Peterskhan/Rhea/Rhea - ESP32_WROOM32D.sch

## KiCad design Rhea - ESP32_WROOM32D.sch (2020-02-20)

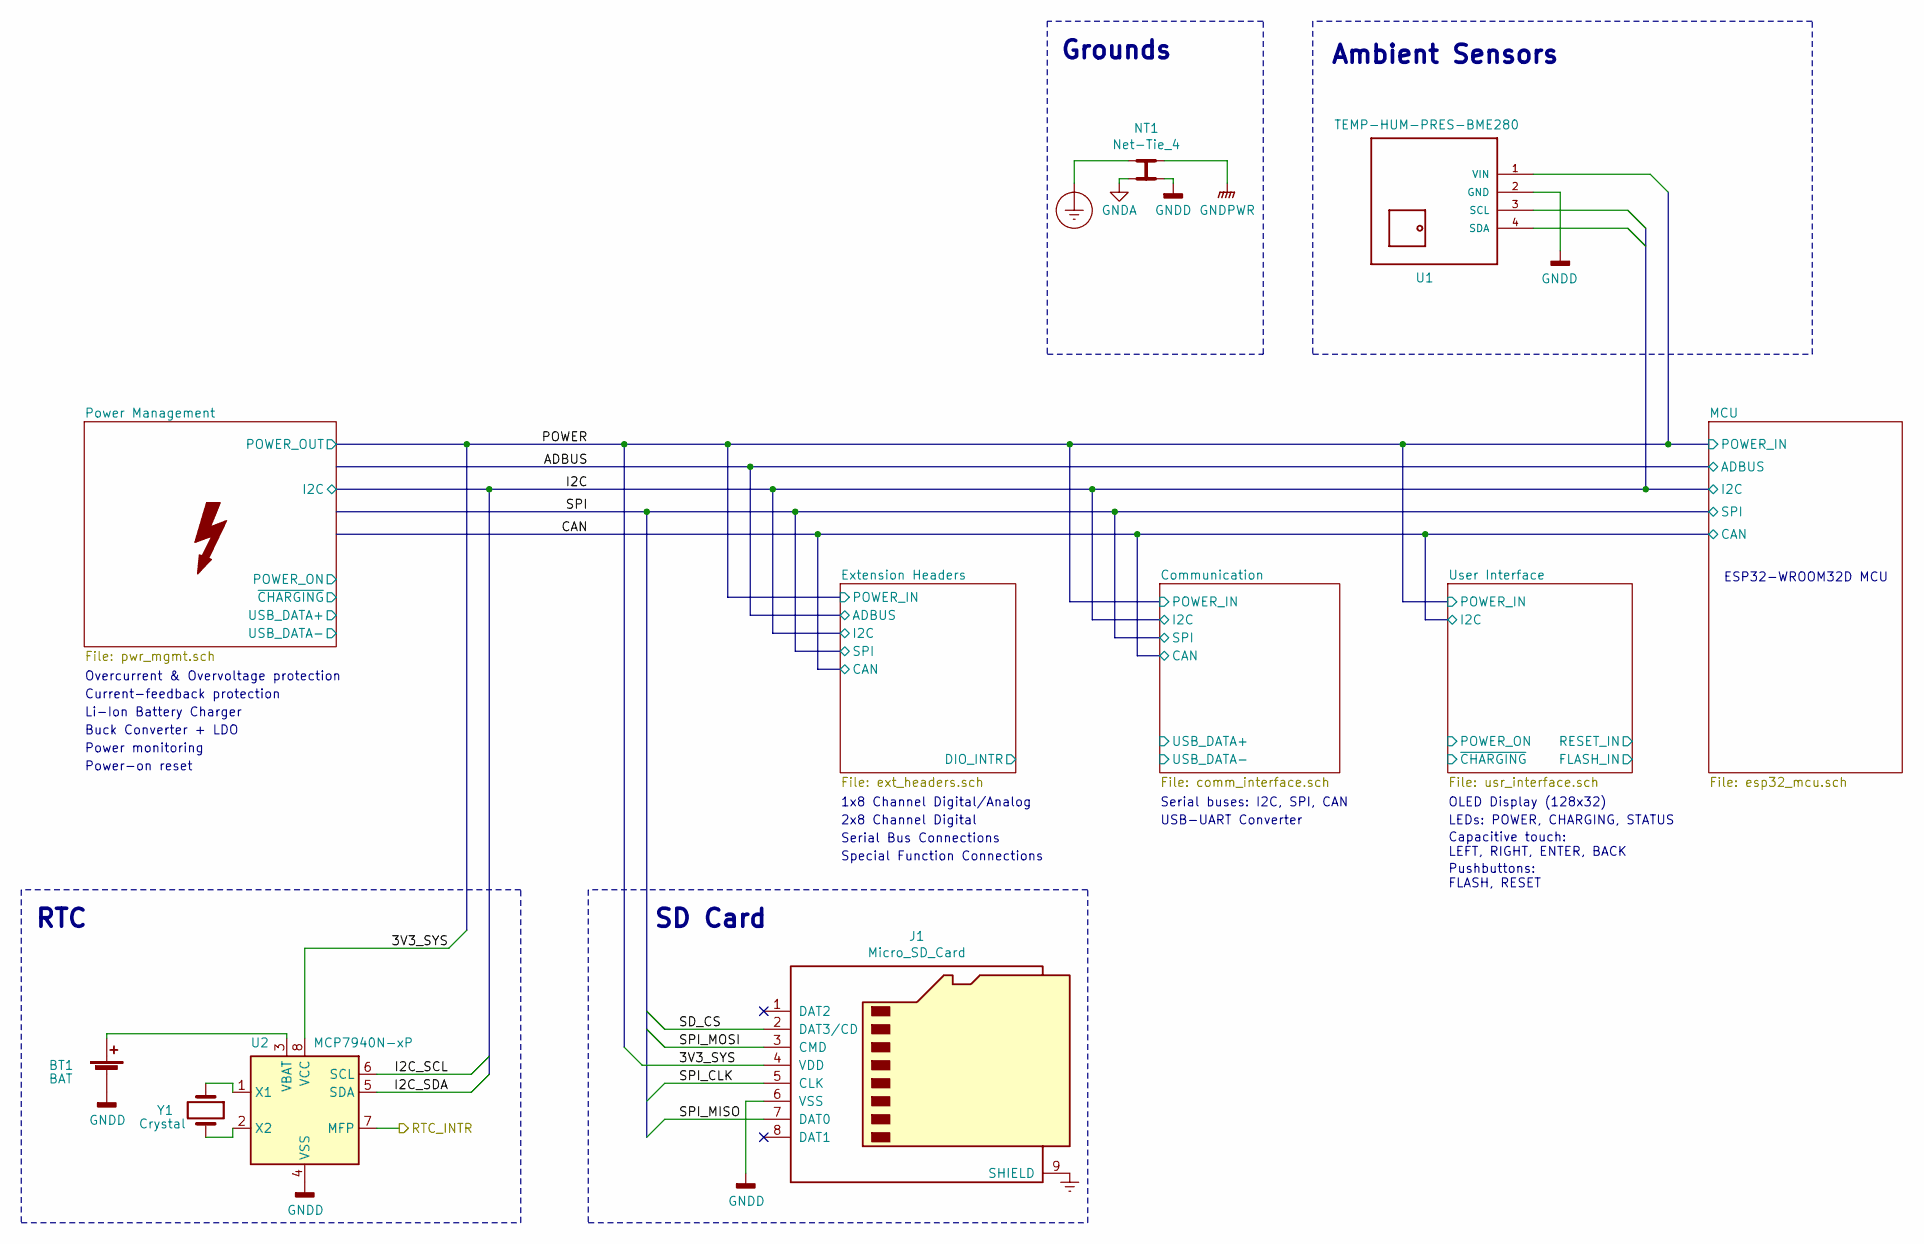
[picture p9: schematic Rhea - ESP32_WROOM32D.sch]

Parts:
BT1: BAT
J1: Micro_SD_Card
NT1: Net-Tie_4
U1: TEMP-HUM-PRES-BME280
U2: MCP7940N-xP
Y1: Crystal

Connections:
3V3_SYS: J1.4 (VDD), U2.8 (VCC)
Earth: J1.9 (SHIELD)
Earth_Protective: NT1.1
GNDA: NT1.3
GNDD: BT1.2 (-), J1.6 (VSS), NT1.4, U1.2 (GND), U2.4 (VSS)
GNDPWR: NT1.2
I2C_SCL: U2.6 (SCL)
I2C_SDA: U2.5 (SDA)
unnamed: BT1.1 (+), U2.3 (VBAT)
unnamed: U2.1 (X1), Y1.1
unnamed: U2.2 (X2), Y1.2
RTC_INTR: U2.7 (MFP)
SD_CS: J1.2 (DAT3/CD)
SPI_CLK: J1.5 (CLK)
SPI_MISO: J1.7 (DAT0)
SPI_MOSI: J1.3 (CMD)

Notes on the sheet:
Overcurrent & Overvoltage protection
Buck Converter + LDO
Current-feedback protection
Power monitoring
Power-on reset
Li-Ion Battery Charger
ESP32-WROOM32D MCU
Serial buses: I2C, SPI, CAN
1x8 Channel Digital/Analog
Pushbuttons: FLASH, RESET
Capacitive touch: LEFT, RIGHT, ENTER, BACK
LEDs: POWER, CHARGING, STATUS
OLED Display (128x32)
RTC
SD Card
Ambient Sensors
2x8 Channel Digital
Serial Bus Connections
Special Function Connections
USB-UART Converter
Grounds
