Peterskhan/Rhea/esp32_mcu.sch

## KiCad design esp32_mcu.sch (2020-02-20)

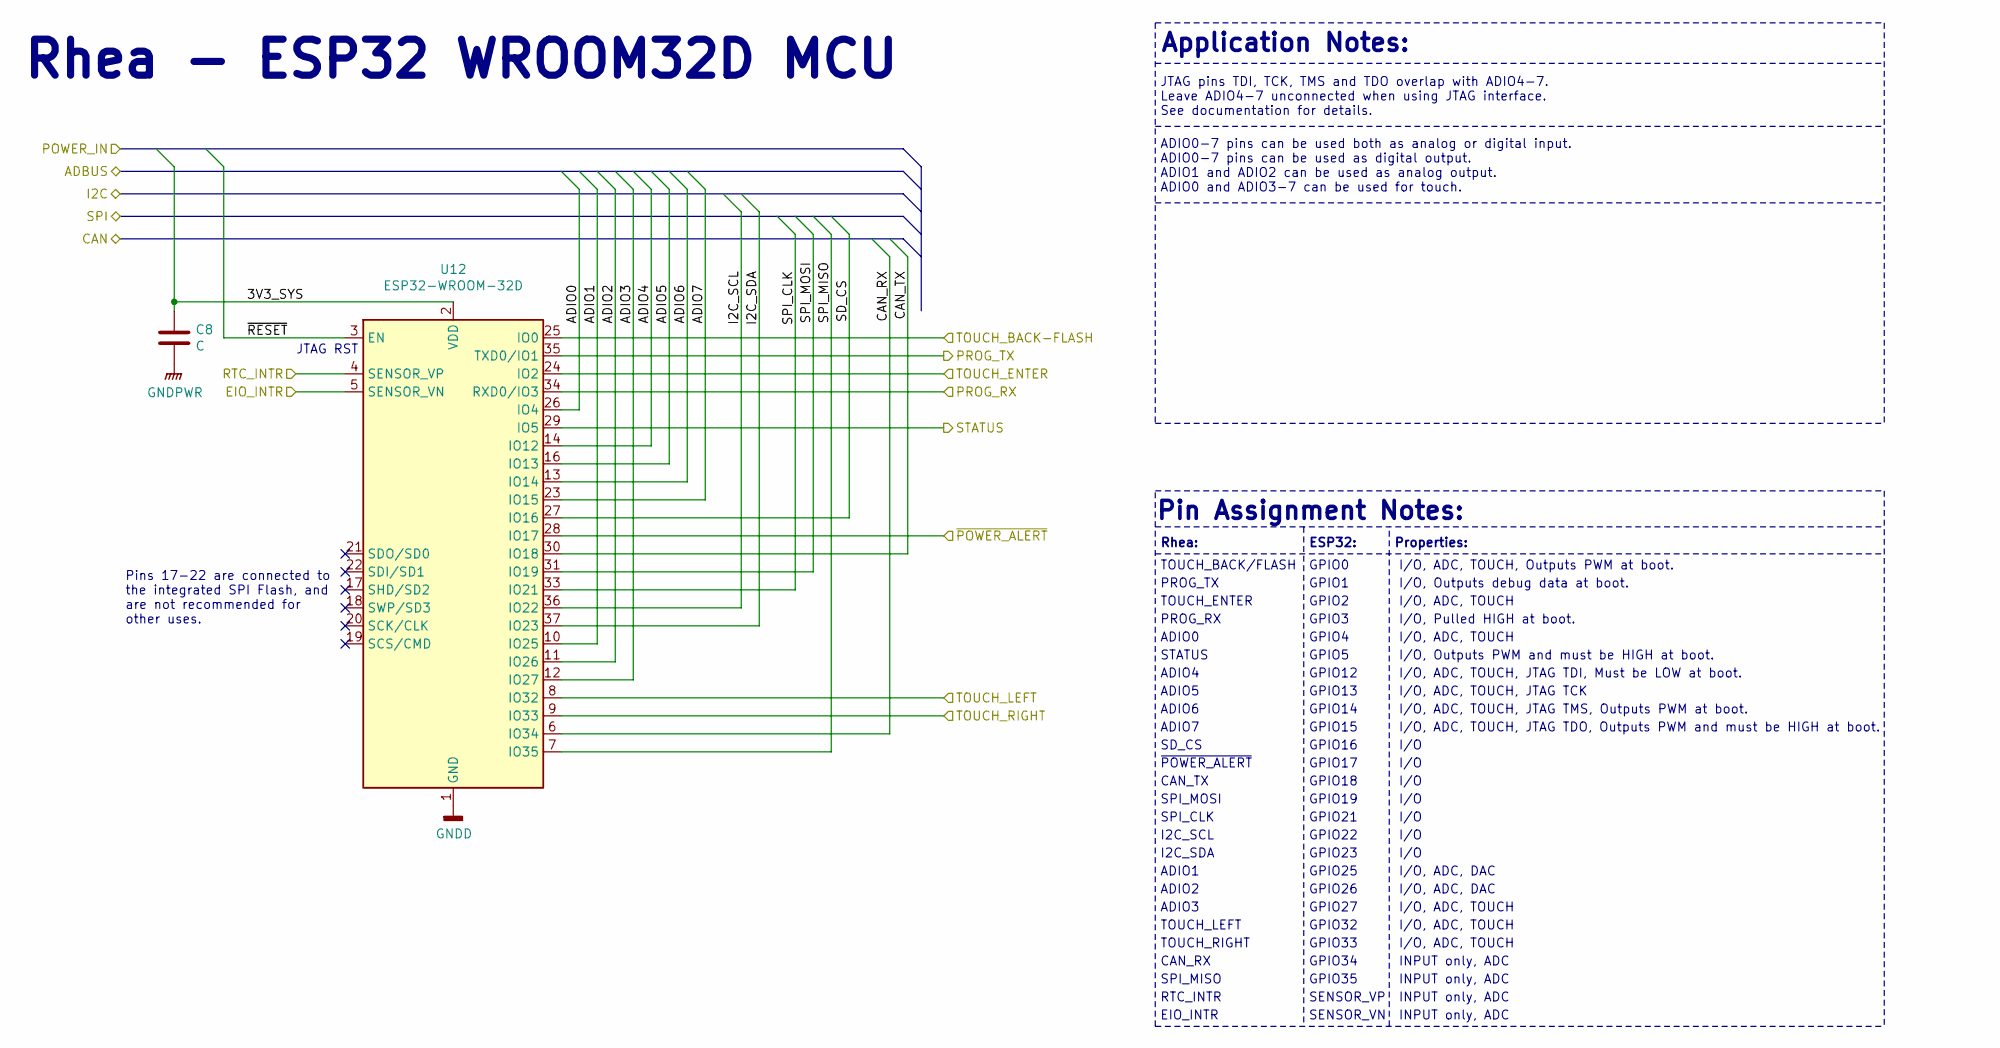
[picture p10: schematic esp32_mcu.sch]

Parts:
C8: C
U12: ESP32-WROOM-32D; ESP32-WROOM-32

Connections:
3V3_SYS: C8.1, U12.2 (VDD)
ADIO0: U12.26 (IO4)
ADIO1: U12.10 (IO25)
ADIO2: U12.11 (IO26)
ADIO3: U12.12 (IO27)
ADIO4: U12.14 (IO12)
ADIO5: U12.16 (IO13)
ADIO6: U12.13 (IO14)
ADIO7: U12.23 (IO15)
CAN_RX: U12.6 (IO34)
CAN_TX: U12.30 (IO18)
EIO_INTR: U12.5 (SENSOR_VN)
GNDD: U12.1 (GND), U12.15 (GND), U12.38 (GND)
GNDPWR: C8.2
I2C_SCL: U12.36 (IO22)
I2C_SDA: U12.37 (IO23)
PROG_RX: U12.34 (RXD0/IO3)
PROG_TX: U12.35 (TXD0/IO1)
RTC_INTR: U12.4 (SENSOR_VP)
SD_CS: U12.27 (IO16)
SPI_CLK: U12.33 (IO21)
SPI_MISO: U12.7 (IO35)
SPI_MOSI: U12.31 (IO19)
STATUS: U12.29 (IO5)
TOUCH_BACK-FLASH: U12.25 (IO0)
TOUCH_ENTER: U12.24 (IO2)
TOUCH_LEFT: U12.8 (IO32)
TOUCH_RIGHT: U12.9 (IO33)
~POWER_ALERT: U12.28 (IO17)
~RESET: U12.3 (EN)

Notes on the sheet:
I/O, ADC, TOUCH, Outputs PWM at boot.
INPUT only, ADC
I/O, Outputs debug data at boot.
I/O, ADC, TOUCH
I/O, Pulled HIGH at boot.
I/O, Outputs PWM and must be HIGH at boot.
I/O, ADC, TOUCH, JTAG TDI, Must be LOW at boot.
I/O, ADC, TOUCH, JTAG TCK
I/O, ADC, TOUCH, JTAG TMS, Outputs PWM at boot.
I/O, ADC, TOUCH, JTAG TDO, Outputs PWM and must be HIGH at boot.
I/O
I/O, ADC, DAC
JTAG RST
TOUCH_RIGHT
ADIO2
ADIO1
TOUCH_BACK/FLASH
TOUCH_ENTER
TOUCH_LEFT
ADIO3
ADIO0
ADIO4
ADIO5
ADIO6
ADIO7
I2C_SCL
I2C_SDA
SPI_MISO
SPI_MOSI
SPI_CLK
CAN_RX
CAN_TX
STATUS
JTAG pins TDI, TCK, TMS and TDO overlap with ADIO4-7. Leave ADIO4-7 unconnected when using JTAG interface. See documentation for details.
Application Notes:
ADIO0-7 pins can be used both as analog or digital input. ADIO0-7 pins can be used as digital output. ADIO1 and ADIO2 can be used as analog output. ADIO0 and ADIO3-7 can be used for touch.
Pin Assignment Notes:
SD_CS
PROG_RX
PROG_TX
Pins 17-22 are connected to the integrated SPI Flash, and are not recommended for other uses.
Rhea:
ESP32:
Properties:
GPIO0
GPIO1
GPIO2
GPIO3
GPIO4
GPIO5
GPIO12
GPIO13
GPIO14
GPIO15
GPIO16
GPIO17
GPIO18
GPIO19
GPIO21
GPIO22
GPIO23
GPIO25
GPIO26
GPIO27
GPIO32
GPIO33
GPIO34
GPIO35
SENSOR_VP
SENSOR_VN
RTC_INTR
EIO_INTR
Rhea - ESP32 WROOM32D MCU
~POWER_ALERT
