Peterskhan/Rhea/ext_headers.sch

## KiCad design ext_headers.sch (2020-02-20)

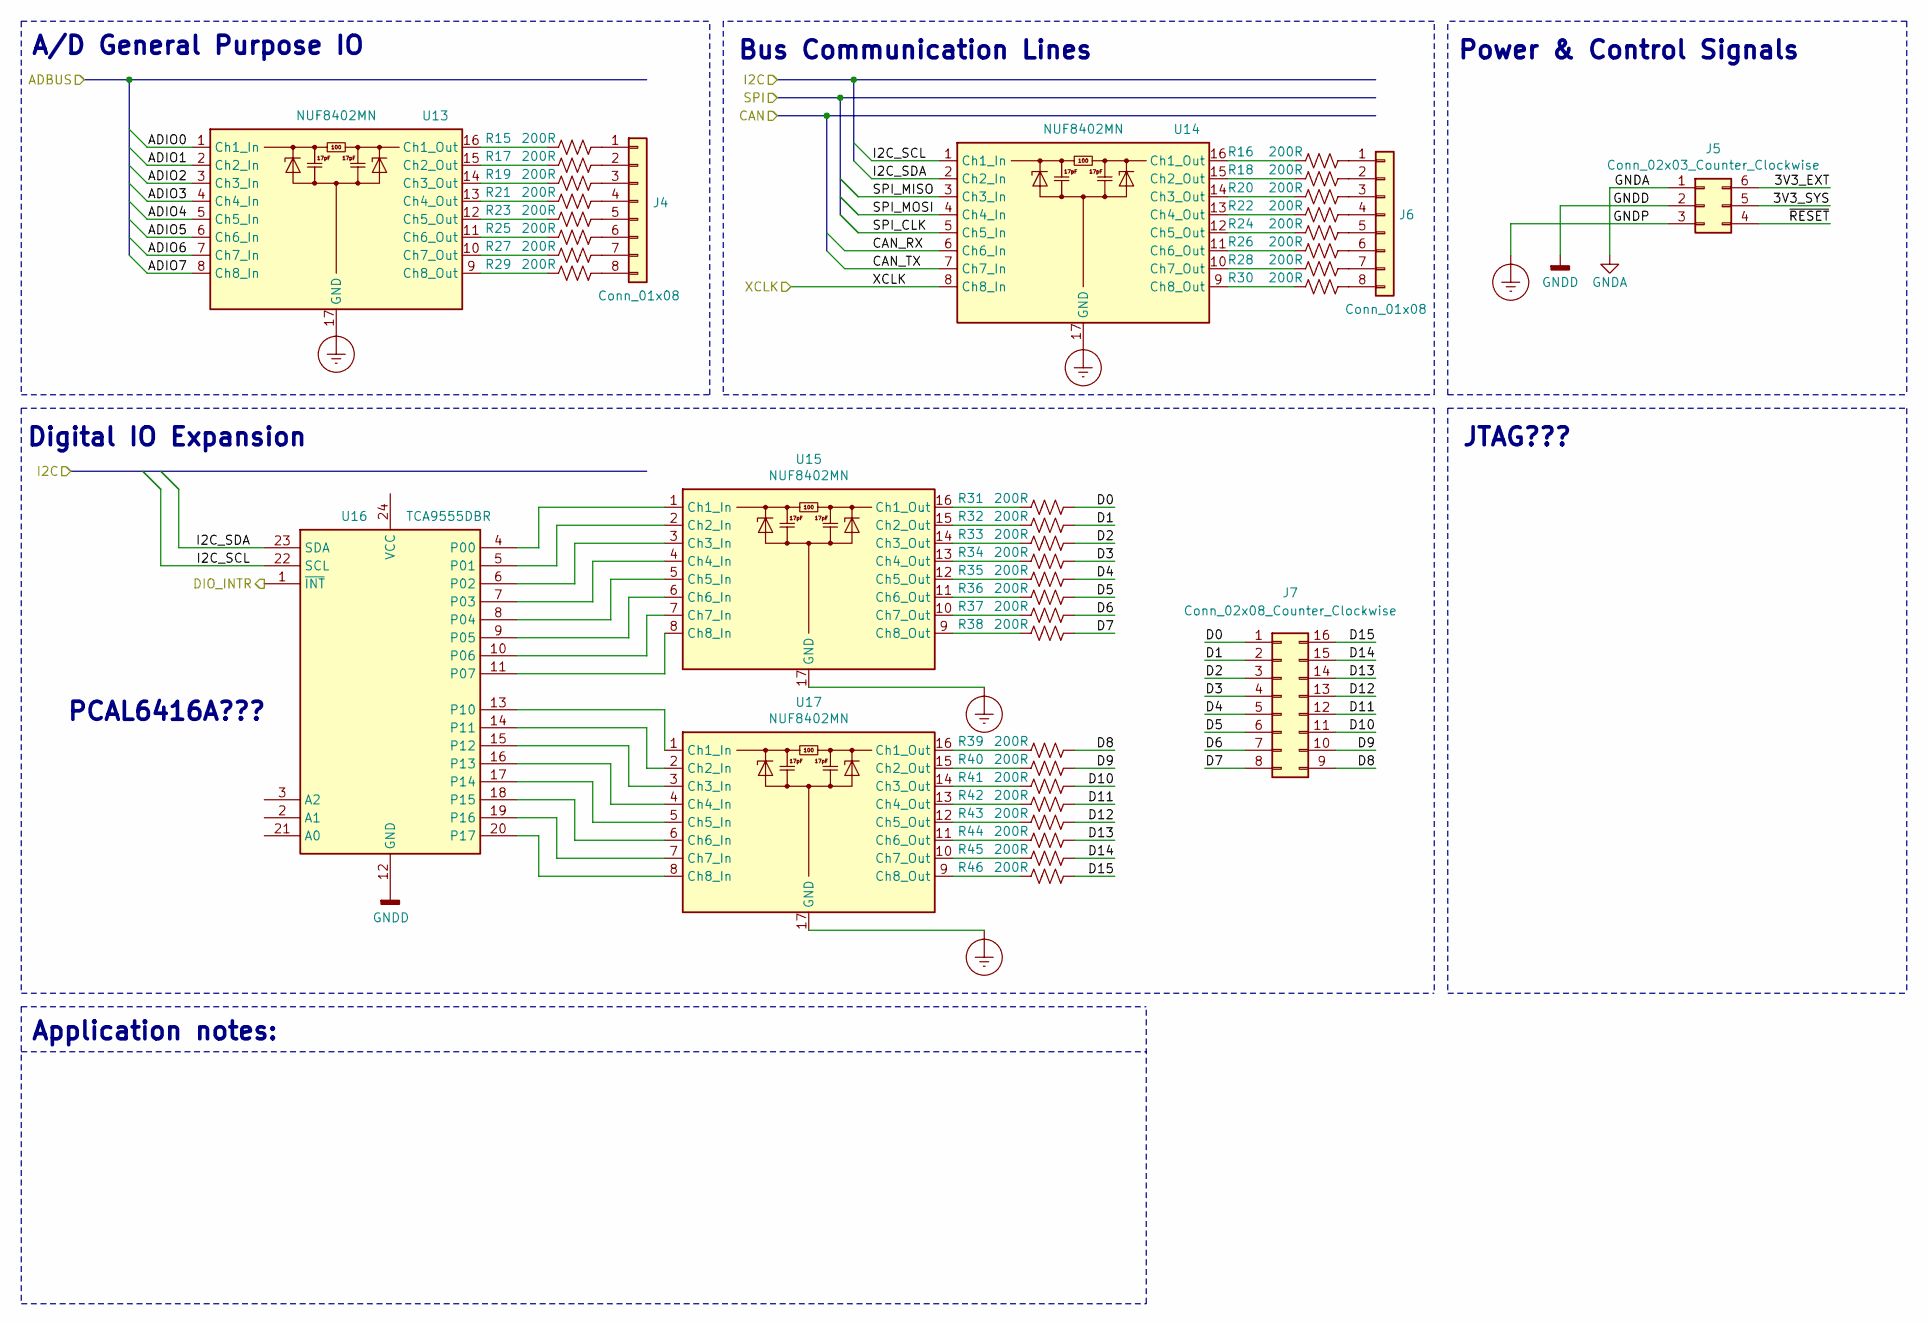
[picture p11: schematic ext_headers.sch]

Parts:
J4, J6: Conn_01x08
J5: Conn_02x03_Counter_Clockwise
J7: Conn_02x08_Counter_Clockwise
R15, R16, R17, R18, R19, R20, R21, R22, R23, R24, R25, R26, R27, R28, R29, R30, R31, R32, R33, R34, R35, R36, R37, R38, R39, R40, R41, R42, R43, R44, R45, R46: 200R
U13, U14, U15, U17: NUF8402MN; DFN-16-1EP_3x5mm_P0.5mm_EP1.66x4.4mm
U16: TCA9555DBR; SSOP-24_5.3x8.2mm_P0.65mm

Connections:
3V3_EXT: J5.6
3V3_SYS: J5.5
ADIO0: U13.1 (Ch1_In)
ADIO1: U13.2 (Ch2_In)
ADIO2: U13.3 (Ch3_In)
ADIO3: U13.4 (Ch4_In)
ADIO4: U13.5 (Ch5_In)
ADIO5: U13.6 (Ch6_In)
ADIO6: U13.7 (Ch7_In)
ADIO7: U13.8 (Ch8_In)
CAN_RX: U14.6 (Ch6_In)
CAN_TX: U14.7 (Ch7_In)
D0: J7.1, R31.1
D1: J7.2, R32.1
D2: J7.3, R33.1
D3: J7.4, R34.1
D4: J7.5, R35.1
D5: J7.6, R36.1
D6: J7.7, R37.1
D7: J7.8, R38.1
D8: J7.9, R39.1
D9: J7.10, R40.1
D10: J7.11, R41.1
D11: J7.12, R42.1
D12: J7.13, R43.1
D13: J7.14, R44.1
D14: J7.15, R45.1
D15: J7.16, R46.1
DIO_INTR: U16.1 (~INT)
Earth_Protective: J5.3, U13.17 (GND), U14.17 (GND), U15.17 (GND), U17.17 (GND)
GNDA: J5.1
GNDD: J5.2, U16.12 (GND)
I2C_SCL: U14.1 (Ch1_In), U16.22 (SCL)
I2C_SDA: U14.2 (Ch2_In), U16.23 (SDA)
unnamed: J4.1, R15.1
unnamed: J4.2, R17.1
unnamed: J4.3, R19.1
unnamed: J4.4, R21.1
unnamed: J4.5, R23.1
unnamed: J4.6, R25.1
unnamed: J4.7, R27.1
unnamed: J4.8, R29.1
unnamed: J6.1, R16.1
unnamed: J6.2, R18.1
unnamed: J6.3, R20.1
unnamed: J6.4, R22.1
unnamed: J6.5, R24.1
unnamed: J6.6, R26.1
unnamed: J6.7, R28.1
unnamed: J6.8, R30.1
unnamed: R15.2, U13.16 (Ch1_Out)
unnamed: R16.2, U14.16 (Ch1_Out)
unnamed: R17.2, U13.15 (Ch2_Out)
unnamed: R18.2, U14.15 (Ch2_Out)
unnamed: R19.2, U13.14 (Ch3_Out)
unnamed: R20.2, U14.14 (Ch3_Out)
unnamed: R21.2, U13.13 (Ch4_Out)
unnamed: R22.2, U14.13 (Ch4_Out)
unnamed: R23.2, U13.12 (Ch5_Out)
unnamed: R24.2, U14.12 (Ch5_Out)
unnamed: R25.2, U13.11 (Ch6_Out)
unnamed: R26.2, U14.11 (Ch6_Out)
unnamed: R27.2, U13.10 (Ch7_Out)
unnamed: R28.2, U14.10 (Ch7_Out)
unnamed: R29.2, U13.9 (Ch8_Out)
unnamed: R30.2, U14.9 (Ch8_Out)
unnamed: R31.2, U15.16 (Ch1_Out)
unnamed: R32.2, U15.15 (Ch2_Out)
unnamed: R33.2, U15.14 (Ch3_Out)
unnamed: R34.2, U15.13 (Ch4_Out)
unnamed: R35.2, U15.12 (Ch5_Out)
unnamed: R36.2, U15.11 (Ch6_Out)
unnamed: R37.2, U15.10 (Ch7_Out)
unnamed: R38.2, U15.9 (Ch8_Out)
unnamed: R39.2, U17.16 (Ch1_Out)
unnamed: R40.2, U17.15 (Ch2_Out)
unnamed: R41.2, U17.14 (Ch3_Out)
unnamed: R42.2, U17.13 (Ch4_Out)
unnamed: R43.2, U17.12 (Ch5_Out)
unnamed: R44.2, U17.11 (Ch6_Out)
unnamed: R45.2, U17.10 (Ch7_Out)
unnamed: R46.2, U17.9 (Ch8_Out)
unnamed: U15.1 (Ch1_In), U16.4 (P00)
unnamed: U15.2 (Ch2_In), U16.5 (P01)
unnamed: U15.3 (Ch3_In), U16.6 (P02)
unnamed: U15.4 (Ch4_In), U16.7 (P03)
unnamed: U15.5 (Ch5_In), U16.8 (P04)
unnamed: U15.6 (Ch6_In), U16.9 (P05)
unnamed: U15.7 (Ch7_In), U16.10 (P06)
unnamed: U15.8 (Ch8_In), U16.11 (P07)
unnamed: U16.13 (P10), U17.1 (Ch1_In)
unnamed: U16.14 (P11), U17.2 (Ch2_In)
unnamed: U16.15 (P12), U17.3 (Ch3_In)
unnamed: U16.16 (P13), U17.4 (Ch4_In)
unnamed: U16.17 (P14), U17.5 (Ch5_In)
unnamed: U16.18 (P15), U17.6 (Ch6_In)
unnamed: U16.19 (P16), U17.7 (Ch7_In)
unnamed: U16.20 (P17), U17.8 (Ch8_In)
SPI_CLK: U14.5 (Ch5_In)
SPI_MISO: U14.3 (Ch3_In)
SPI_MOSI: U14.4 (Ch4_In)
XCLK: U14.8 (Ch8_In)
~RESET: J5.4

Notes on the sheet:
A/D General Purpose IO
Bus Communication Lines
Power & Control Signals
Digital IO Expansion
Application notes:
JTAG???
PCAL6416A???
