Peterskhan/Rhea/pwr_mgmt.sch

## KiCad design pwr_mgmt.sch (2020-02-20)

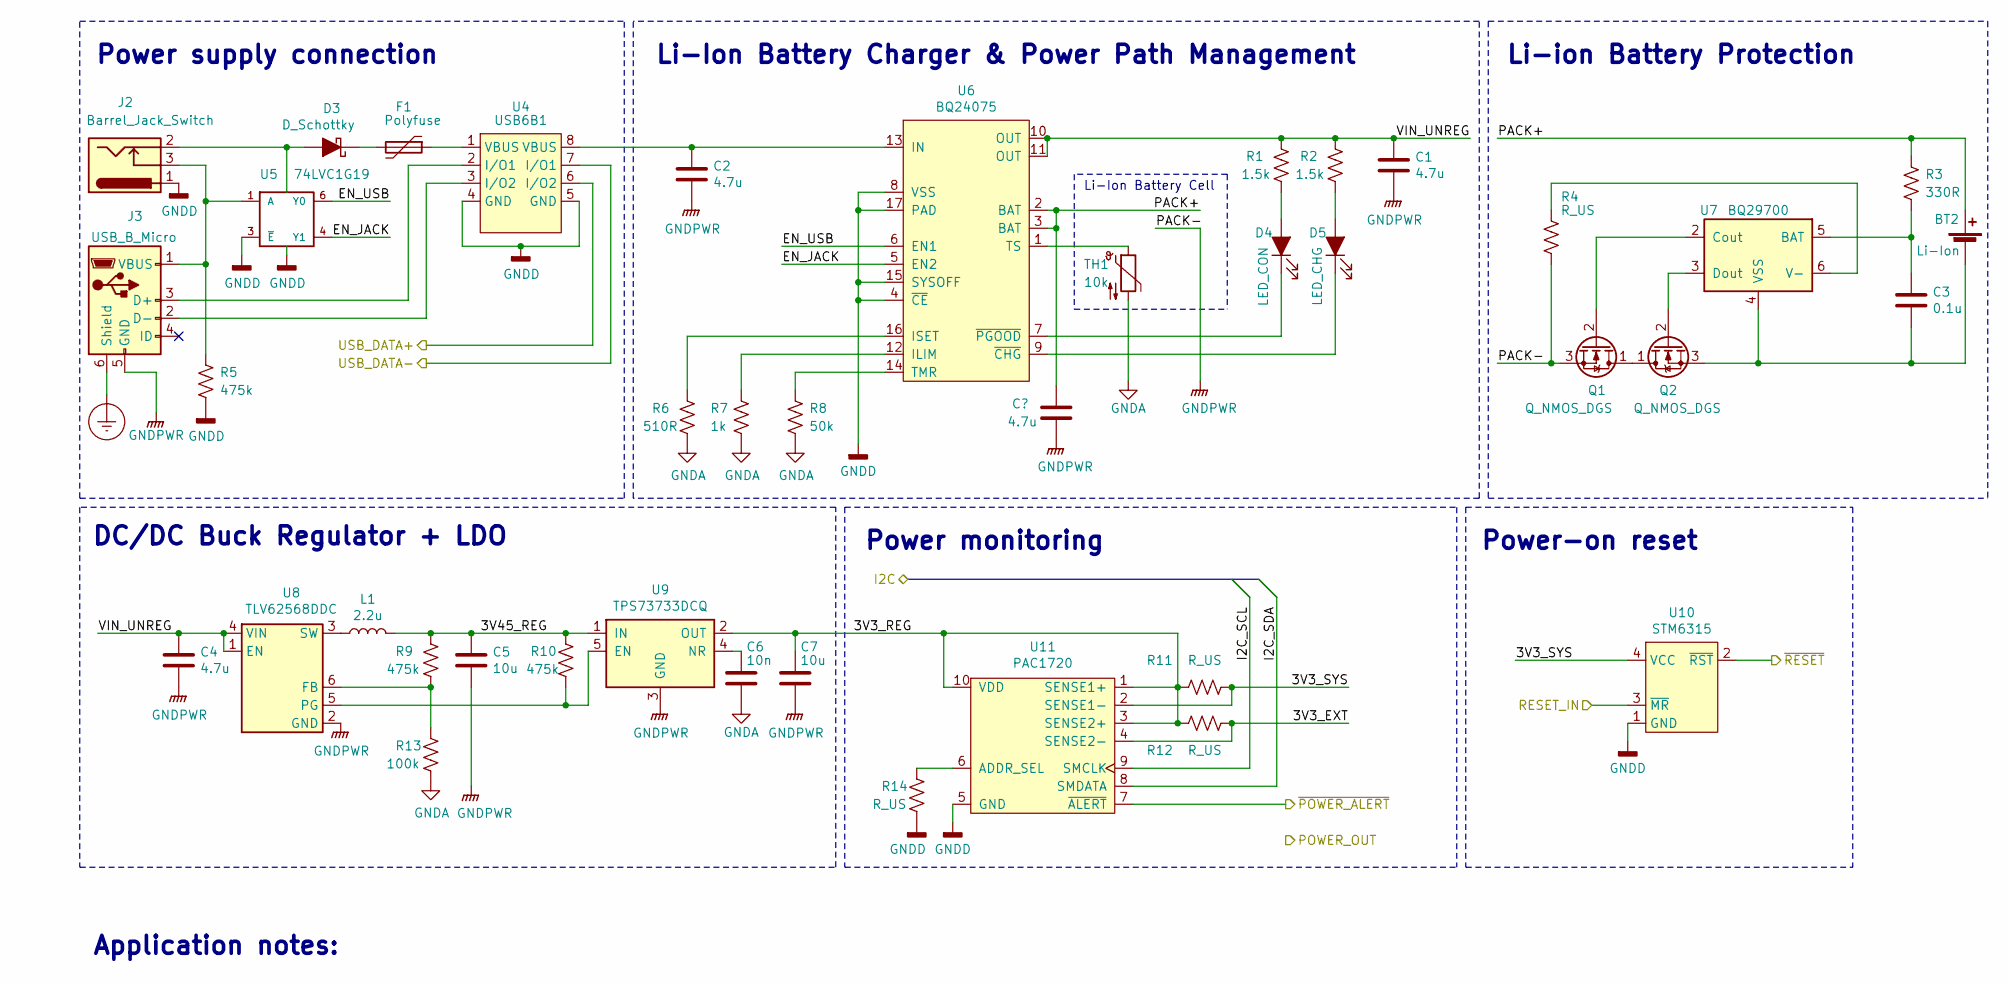
[picture p12: schematic pwr_mgmt.sch]

Parts:
BT2: Li-Ion
C1, C2, C4: 4.7u
C3: 0.1u
C5, C7: 10u
C6: 10n
D3: D_Schottky
D4: LED_CON
D5: LED_CHG
F1: Polyfuse
J2: Barrel_Jack_Switch
J3: USB_B_Micro
L1: 2.2u
Q1, Q2: Q_NMOS_DGS
R1, R2: 1.5k
R3: 330R
R4, R11, R12, R14: R_US
R5, R9, R10: 475k
R6: 510R
R7: 1k
R8: 50k
R13: 100k
TH1: 10k
U4: USB6B1; SOIC-8_3.9x4.9mm_P1.27mm
U5: 74LVC1G19
U6: BQ24075
U7: BQ29700; WSON-6_1.5x1.5mm_P0.5mm
U8: TLV62568DDC; SOT-23-6
U9: TPS73733DCQ; SOT-223-6
U10: STM6315; SOT-143
U11: PAC1720; DFN-10-1EP_3x3mm_P0.5mm_EP1.65x2.38mm

Connections:
3V3_EXT: R12.2, U11.4 (SENSE2-)
3V3_REG: C7.1, R11.2, R12.1, U9.2 (OUT), U11.1 (SENSE1+), U11.3 (SENSE2+), U11.10 (VDD)
3V3_SYS: R11.1, U10.4 (VCC), U11.2 (SENSE1-)
3V45_REG: C5.1, L1.2, R9.1, R10.1, U9.1 (IN)
EN_JACK: U5.4 (Y1), U6.5 (EN2)
EN_USB: U5.6 (Y0), U6.6 (EN1)
Earth_Protective: J3.6 (Shield)
GNDA: C6.2, R6.2, R7.2, R8.2, R13.2, TH1.2
GNDD: J2.1, R5.2, R14.2, U4.4 (GND), U4.5 (GND), U5.2 (GND), U5.3 (~E), U6.4 (~CE), U6.8 (VSS), U6.15 (SYSOFF), U6.17 (PAD), U10.1 (GND), U11.5 (GND)
GNDPWR: C1.2, C2.2, C4.2, C5.2, C7.2, J3.5 (GND), Q1.3 (S), R4.2, U8.2 (GND), U9.3 (GND)
I2C_SCL: U11.9 (SMCLK)
I2C_SDA: U11.8 (SMDATA)
unnamed: BT2.2 (-), C3.2, Q2.3 (S), U7.4 (VSS)
unnamed: C2.1, U4.8 (VBUS), U6.13 (IN)
unnamed: C3.1, R3.2, U7.5 (BAT)
unnamed: C6.1, U9.4 (NR)
unnamed: D3.1 (K), F1.2
unnamed: D3.2 (A), J2.2, U5.5 (VCC)
unnamed: D4.1 (K), U6.7 (~PGOOD)
unnamed: D4.2 (A), R1.2
unnamed: D5.1 (K), U6.9 (~CHG)
unnamed: D5.2 (A), R2.2
unnamed: F1.1, U4.1 (VBUS)
unnamed: J2.3, J3.1 (VBUS), R5.1, U5.1 (A)
unnamed: J3.2 (D-), U4.3 (I/O2)
unnamed: J3.3 (D+), U4.2 (I/O1)
unnamed: L1.1, U8.3 (SW)
unnamed: Q1.1 (D), Q2.1 (D)
unnamed: Q1.2 (G), U7.2 (Cout)
unnamed: Q2.2 (G), U7.3 (Dout)
unnamed: R4.1, U7.6 (V-)
unnamed: R6.1, U6.16 (ISET)
unnamed: R7.1, U6.12 (ILIM)
unnamed: R8.1, U6.14 (TMR)
unnamed: R10.2, U8.5 (PG), U9.5 (EN)
unnamed: R9.2, R13.1, U8.6 (FB)
unnamed: R14.1, U11.6 (ADDR_SEL)
unnamed: TH1.1, U6.1 (TS)
PACK+: BT2.1 (+), R3.1, U6.2 (BAT), U6.3 (BAT)
RESET_IN: U10.3 (~MR)
USB_DATA+: U4.6 (I/O2)
USB_DATA-: U4.7 (I/O1)
VIN_UNREG: C1.1, C4.1, R1.1, R2.1, U6.10 (OUT), U6.11 (OUT), U8.1 (EN), U8.4 (VIN)
~POWER_ALERT: U11.7 (~ALERT)
~RESET: U10.2 (~RST)

Notes on the sheet:
Li-Ion Battery Charger & Power Path Management
Power supply connection
Power monitoring
Li-Ion Battery Cell
Li-ion Battery Protection
DC/DC Buck Regulator + LDO
Power-on reset
Application notes:
