Peterskhan/Rhea/(commit log)

2020-01-24 Remove obsolete files.
    [rt_clock.sch, storage_sd.sch]
2020-01-25 Reshuffled MCU connections.
    [Rhea - ESP32_WROOM32D.sch, comm_interface.sch, esp32_mcu.sch, ext_headers.sch, pwr_mgmt.sch, usr_interface.sch]
2020-01-25 Power management updates.
    [Rhea - ESP32_WROOM32D.sch, pwr_mgmt.sch]
2020-01-26 Power management redesign started, and design documentation.
    [Rhea - ESP32_WROOM32D.sch, pwr_mgmt.sch]
2020-01-28 Power management & Documentation updates, source includes
    [Rhea - ESP32_WROOM32D.sch, pwr_mgmt.sch]
2020-01-29 Automatic charge source selection & Documentation updates.
    [Rhea - ESP32_WROOM32D.sch, pwr_mgmt.sch]
2020-01-30 External headers early draft.
    [Rhea - ESP32_WROOM32D.sch, esp32_mcu.sch, ext_headers.sch, usr_interface.sch]
2020-02-20 Power regulation updates.
    [Rhea - ESP32_WROOM32D.kicad_pcb, Rhea - ESP32_WROOM32D.sch, esp32_mcu.sch, ext_headers.sch, pwr_mgmt.sch]
